gi1mic/FT817-Elecraft-T1-Interface/Photos/IMG_8596.jpg

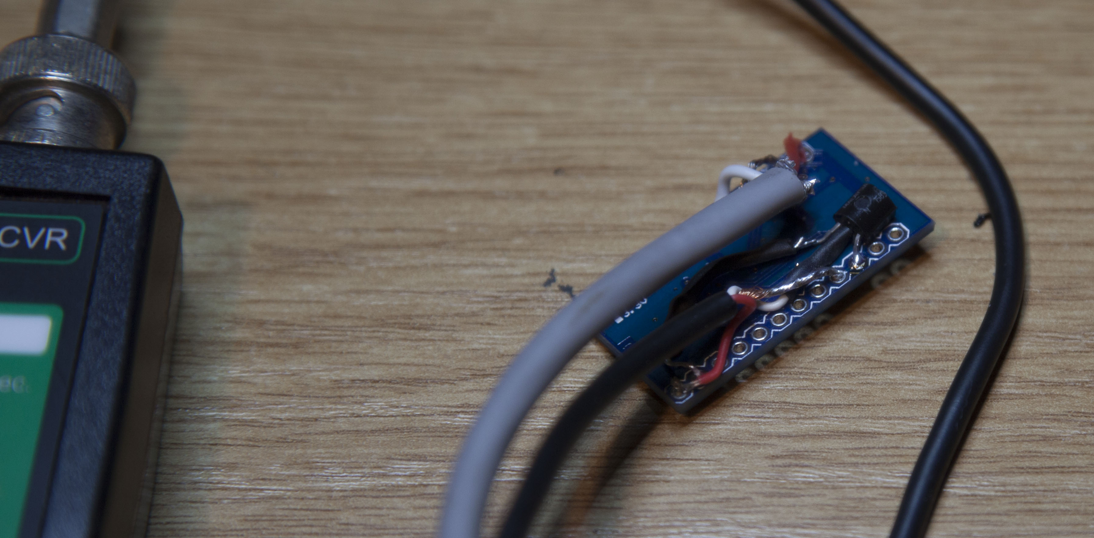
Photos/IMG_8596.jpg
